Mulakulu/ELE340/Lokalt styresystem/dmk_flytdiagram_lokalt_styrsys.pdf

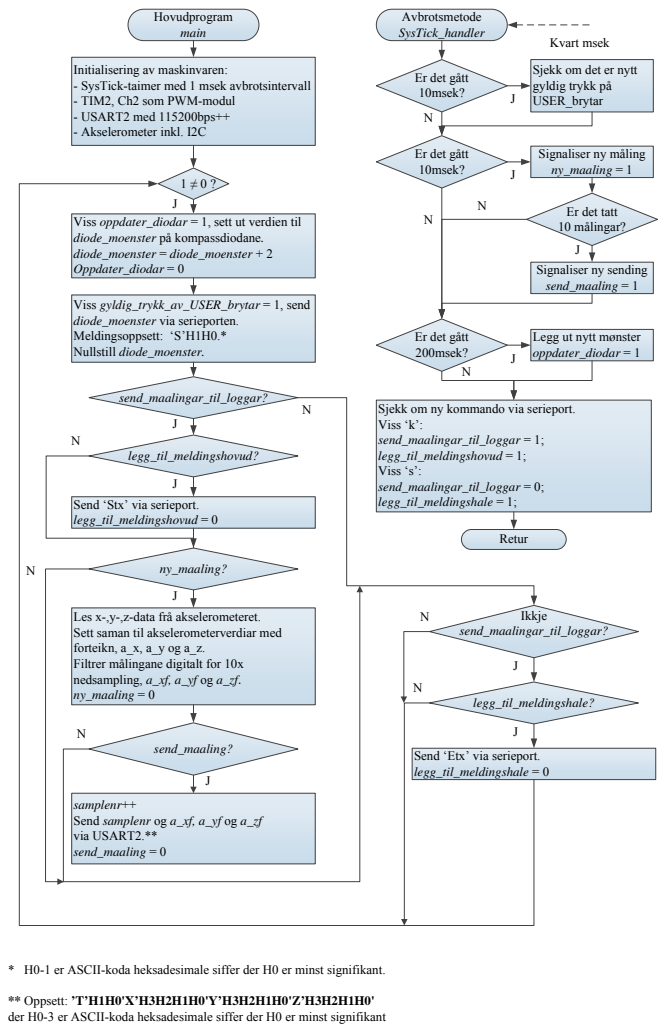
[picture p1: page 1]
Hovudprogram main; Er det gått 10msek?; Legg ut nytt mønster oppdater_diodar = 1; Avbrotsmetode SysTick_handler; Retur; Sjekk om ny kommando via serieport. Viss ‘k’: send_maalingar_til_loggar = 1; legg_til_meldingshovud = 1; Viss ‘s’: send_maalingar_til_loggar = 0; legg_til_meldingshale = 1;; 10msek?; Er det tatt; 10 målingar?; Signaliser ny sending send_maaling = 1; Viss gyldig_trykk_av_USER_brytar = 1, send diode_moenster via serieporten. Meldingsoppsett: ‘S’H1H0.* Nullstill diode_moenster.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

Kvart msek
Sjekk om det er nytt
gyldig trykk på
USER_brytar

Initialisering av maskinvaren:
- SysTick-taimer med 1 msek avbrotsintervall
- TIM2, Ch2 som PWM-modul
- USART2 med 115200bps++
- Akselerometer inkl. I2C

Er det gått

Signaliser ny måling
ny_maaling = 1

Viss oppdater_diodar = 1, sett ut verdien til
diode_moenster på kompassdiodane.
diode_moenster = diode_moenster + 2
Oppdater_diodar = 0

200msek?

Send ‘Stx’ via serieport.
legg_til_meldingshovud = 0

Les x-,y-,z-data frå akselerometeret.
Sett saman til akselerometerverdiar med
forteikn, a_x, a_y og a_z.
Filtrer målingane digitalt for 10x
nedsampling, a_xf, a_yf og a_zf.
ny_maaling = 0

Send ‘Etx’ via serieport.
legg_til_meldingshale = 0

samplenr++
Send samplenr og a_xf, a_yf og a_zf
via USART2.**
send_maaling = 0

* H0-1 er ASCII-koda heksadesimale siffer der H0 er minst signifikant.

** Oppsett: ’T’H1H0'X’H3H2H1H0'Y’H3H2H1H0'Z’H3H2H1H0'
der H0-3 er ASCII-koda heksadesimale siffer der H0 er minst signifikant
