Mulakulu/ELE340/KiCad_files/KiCad_files.kicad_pcb

## KiCad design KiCad_files/KiCad_files.kicad_pcb (2024-11-29)

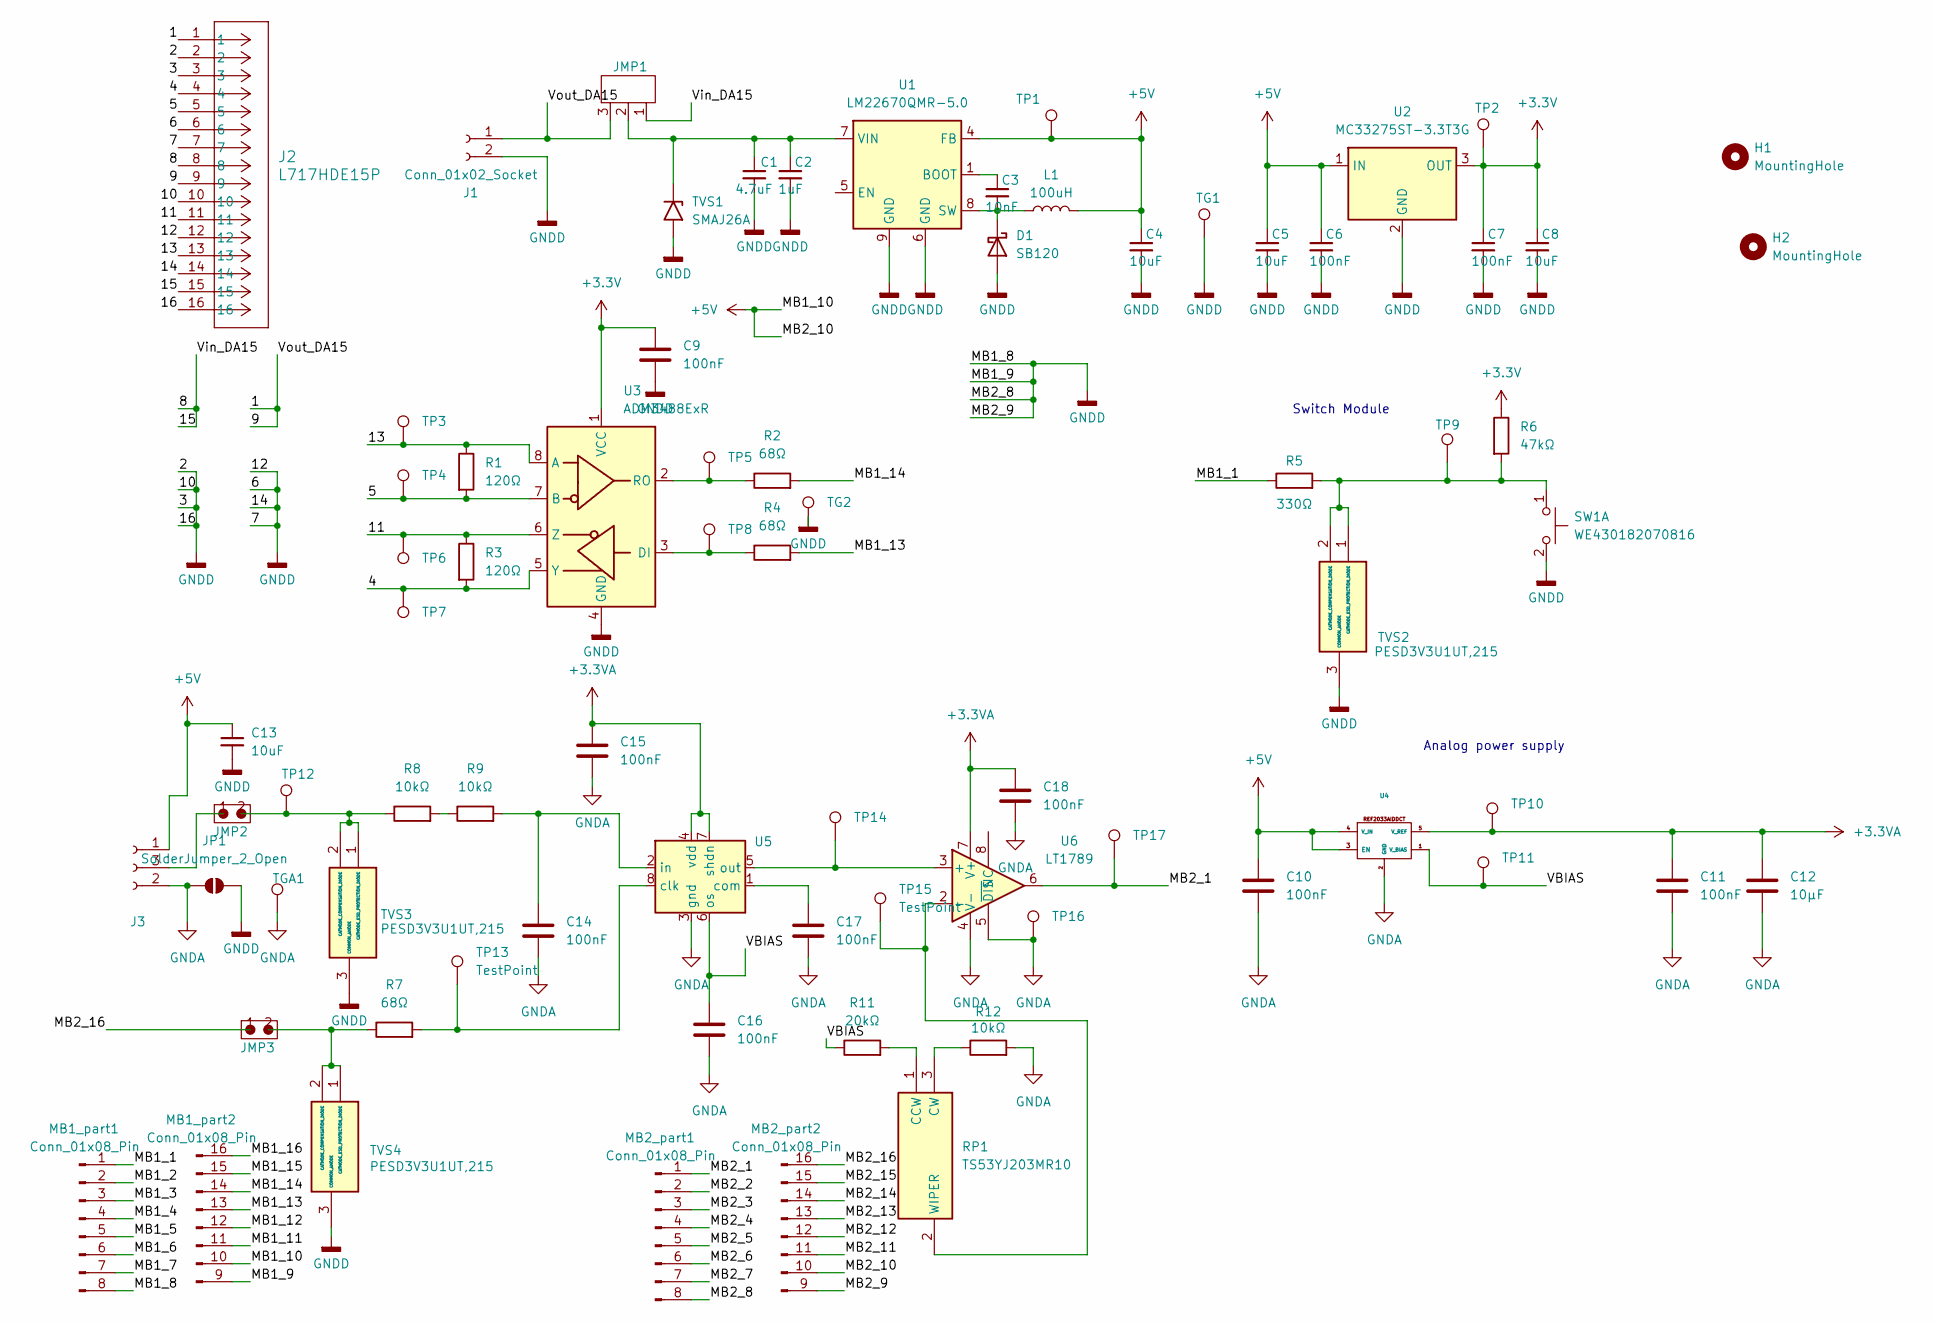
[picture p2: schematic KiCad_files.kicad_sch, Schematic Drawing Proposal]

Parts:
C1: 4.7uF; C_1206_3216Metric_Pad1.33x1.80mm_HandSolder
C2: 1uF; C_1206_3216Metric_Pad1.33x1.80mm_HandSolder
C3: 10nF; C_1206_3216Metric_Pad1.33x1.80mm_HandSolder
C4, C5, C8, C13: 10uF; C_1210_3225Metric_Pad1.33x2.70mm_HandSolder
C6, C7, C9, C10, C11, C14, C15, C16, C17, C18: 100nF; C_1206_3216Metric_Pad1.33x1.80mm_HandSolder
C12: 10μF; C_1210_3225Metric_Pad1.33x2.70mm_HandSolder
D1: SB120; D_MicroSMP_AK
H1, H2: MountingHole; MountingHole_3.2mm_M3
J1: Conn_01x02_Socket; SL35290G
J2: L717HDE15P; 15PinDsub
J3: Conn_01x03_Socket; Pin_Header_1x3_P3.5mm
JMP1: Pin_Header_1x3_P2.54mm
JMP2, JMP3: Pin_Header_2x1_P2.54mm_Vertical
JP1: SolderJumper_2_Open; SolderJumper-2_P1.3mm_Open_RoundedPad1.0x1.5mm
L1: 100uH; SDR2207
MB1_part1, MB2_part1: Conn_01x08_Pin; MB1x8Pins
MB1_part2, MB2_part2: Conn_01x08_Pin; MB1x8Pins_part2
R1, R3: 120Ω; R_1206_3216Metric_Pad1.30x1.75mm_HandSolder
R2, R4, R7: 68Ω; R_1206_3216Metric_Pad1.30x1.75mm_HandSolder
R5: 330Ω; R_1206_3216Metric_Pad1.30x1.75mm_HandSolder
R6: 47kΩ; R_1206_3216Metric_Pad1.30x1.75mm_HandSolder
R8, R9, R12: 10kΩ; R_1206_3216Metric_Pad1.30x1.75mm_HandSolder
R11: 20kΩ; R_1206_3216Metric_Pad1.30x1.75mm_HandSolder
RP1: TS53YJ203MR10; TS53YJ; Manufacturer_Part_Number TS53YJ203MR10
SW1: WE430182070816; Switch WE430182070816
TG1, TG2: TestPoint; testpoint_1.4mm
TGA1: TestPoint; testpoint_1.4mm
TP1, TP2, TP3, TP4, TP5, TP6, TP7, TP8, TP12, TP13, TP14, TP15, TP16, TP17: TestPoint; testpoint_1.4mm
TP9, TP10, TP11: testpoint_1.4mm
TVS1: SMAJ26A; D_SMA
TVS2, TVS3, TVS4: PESD3V3U1UT,215; SOT95P230X110-3N; Manufacturer_Part_Number PESD3V3U1UT,215
U1: LM22670QMR-5.0; SOIC-8-1EP_3.9x4.9mm_P1.27mm_EP2.41x3.81mm
U2: MC33275ST-3.3T3G; SOT-223-3_TabPin2
U3: ADM3488ExR; SOIC-8_3.9x4.9mm_P1.27mm
U4: SOT-23-5
U5: SOIC-8_3.9x4.9mm_P1.27mm
U6: LT1789; SOIC-8_3.9x4.9mm_P1.27mm

Connections:
+3.3V: C7.1, C8.1, C9.1, R6.1, TP2.1, U2.3 (OUT), U3.1 (VCC)
+3.3VA: C11.1, C12.1, C15.1, C18.1, TP10.1, U4.5 (V_REF), U5.4 (vdd), U5.7 (shdn), U6.7 (V+)
+5V: C4.1, C5.1, C6.1, C10.1, C13.1, J3.1, L1.2, MB1_part2.10 (Pin_7), MB2_part2.10 (Pin_7), TP1.1, U1.4 (FB), U2.1 (IN), U4.3 (EN), U4.4 (V_IN)
/1: J1.1, J2.1, J2.9, JMP1.3
/4: J2.4, R3.2, TP7.1, U3.5 (Y)
/5: J2.5, R1.2, TP4.1, U3.7 (B)
/11: J2.11, R3.1, TP6.1, U3.6 (Z)
/13: J2.13, R1.1, TP3.1, U3.8 (A)
/15: J2.8, J2.15, JMP1.1
/MB1_1: MB1_part1.1, R5.1
/MB1_2: MB1_part1.2
/MB1_3: MB1_part1.3
/MB1_4: MB1_part1.4
/MB1_5: MB1_part1.5
/MB1_6: MB1_part1.6
/MB1_7: MB1_part1.7
/MB1_11: MB1_part2.11 (Pin_6)
/MB1_12: MB1_part2.12 (Pin_5)
/MB1_13: MB1_part2.13 (Pin_4), R4.2
/MB1_14: MB1_part2.14 (Pin_3), R2.2
/MB1_15: MB1_part2.15 (Pin_2)
/MB1_16: MB1_part2.16 (Pin_1)
/MB2_1: MB2_part1.1, TP17.1, U6.6
/MB2_2: MB2_part1.2
/MB2_3: MB2_part1.3
/MB2_4: MB2_part1.4
/MB2_5: MB2_part1.5
/MB2_6: MB2_part1.6
/MB2_7: MB2_part1.7
/MB2_11: MB2_part2.11 (Pin_6)
/MB2_12: MB2_part2.12 (Pin_5)
/MB2_13: MB2_part2.13 (Pin_4)
/MB2_14: MB2_part2.14 (Pin_3)
/MB2_15: MB2_part2.15 (Pin_2)
/MB2_16: JMP3.1, MB2_part2.16 (Pin_1)
/VBIAS: C16.1, R11.1, TP11.1, U4.1 (V_BIAS), U5.6 (os)
GNDA: C10.2, C11.2, C12.2, C14.2, C15.2, C16.2, C17.2, C18.2, J3.2 (Pin_3), JP1.1 (A), R12.2, TGA1.1, TP16.1, U4.2 (GND), U5.3 (gnd), U6.4 (V-), U6.5 (~DIS)
GNDD: C1.2, C2.2, C4.2, C5.2, C6.2, C7.2, C8.2, C9.2, C13.2, D1.2 (A), J1.2, J2.2, J2.3, J2.6, J2.7, J2.10, J2.12, J2.14, J2.16, JP1.2 (B), MB1_part1.8, MB1_part2.9 (Pin_8), MB2_part1.8, MB2_part2.9 (Pin_8), SW1.2 (D), TG1.1, TG2.1, TVS1.2 (A2), TVS2.3 (COMMON_ANODE), TVS3.3 (COMMON_ANODE), TVS4.3 (COMMON_ANODE), U1.6 (GND), U1.9 (GND), U2.2 (GND), U3.4 (GND)
unnamed: C3.2, D1.1 (K), L1.1, U1.8 (SW)
unnamed: J3.3 (Pin_2), JMP2.1
unnamed: R8.2, R9.1
unnamed: R11.2, RP1.1 (CCW)
unnamed: R12.1, RP1.3 (CW)
unnamed: RP1.2 (WIPER), TP15.1, U6.2 (-)
unnamed: R5.2, R6.2, SW1.1 (C), TP9.1, TVS2.1 (CATHODE_ESD_PROTECTION_DIODE), TVS2.2 (CATHODE_COMPENSATION_DIODE)
unnamed: C1.1, C2.1, JMP1.2, TVS1.1 (A1), U1.7 (VIN)
unnamed: JMP2.2, R8.1, TP12.1, TVS3.1 (CATHODE_ESD_PROTECTION_DIODE), TVS3.2 (CATHODE_COMPENSATION_DIODE)
unnamed: JMP3.2, R7.1, TVS4.1 (CATHODE_ESD_PROTECTION_DIODE), TVS4.2 (CATHODE_COMPENSATION_DIODE)
unnamed: C3.1, U1.1 (BOOT)
unnamed: R4.1, TP8.1, U3.3 (DI)
unnamed: R2.1, TP5.1, U3.2 (RO)
unnamed: R7.2, TP13.1, U5.8 (clk)
unnamed: C17.1, U5.1 (com)
unnamed: C14.1, R9.2, U5.2 (in)
unnamed: TP14.1, U5.5 (out), U6.3 (+)

Notes on the sheet:
Switch Module
Analog power supply

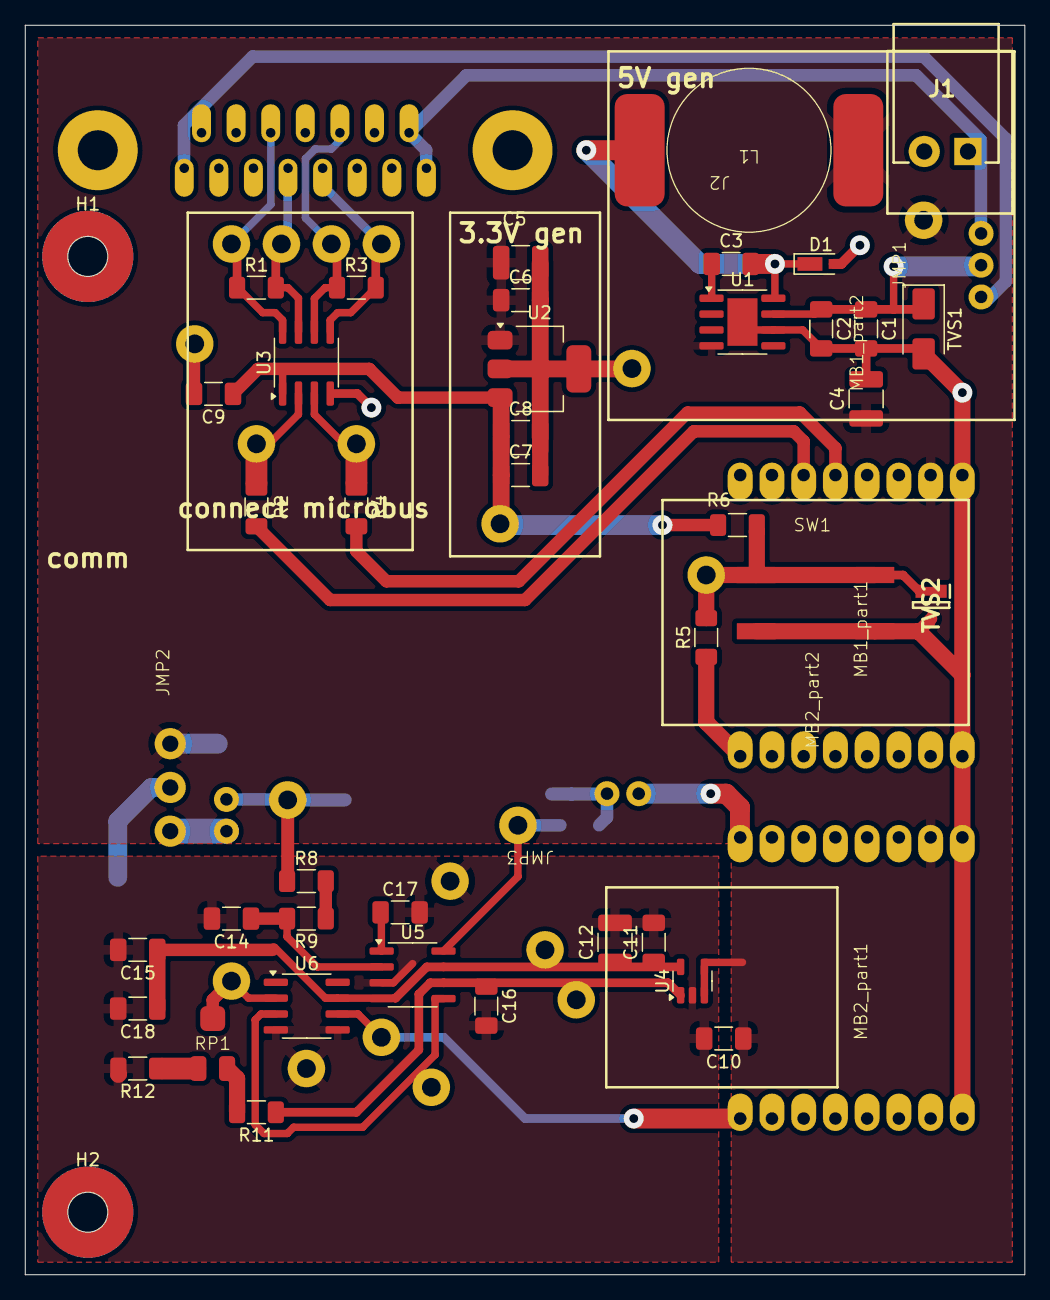
[picture p3: board KiCad_files.kicad_pcb from above]

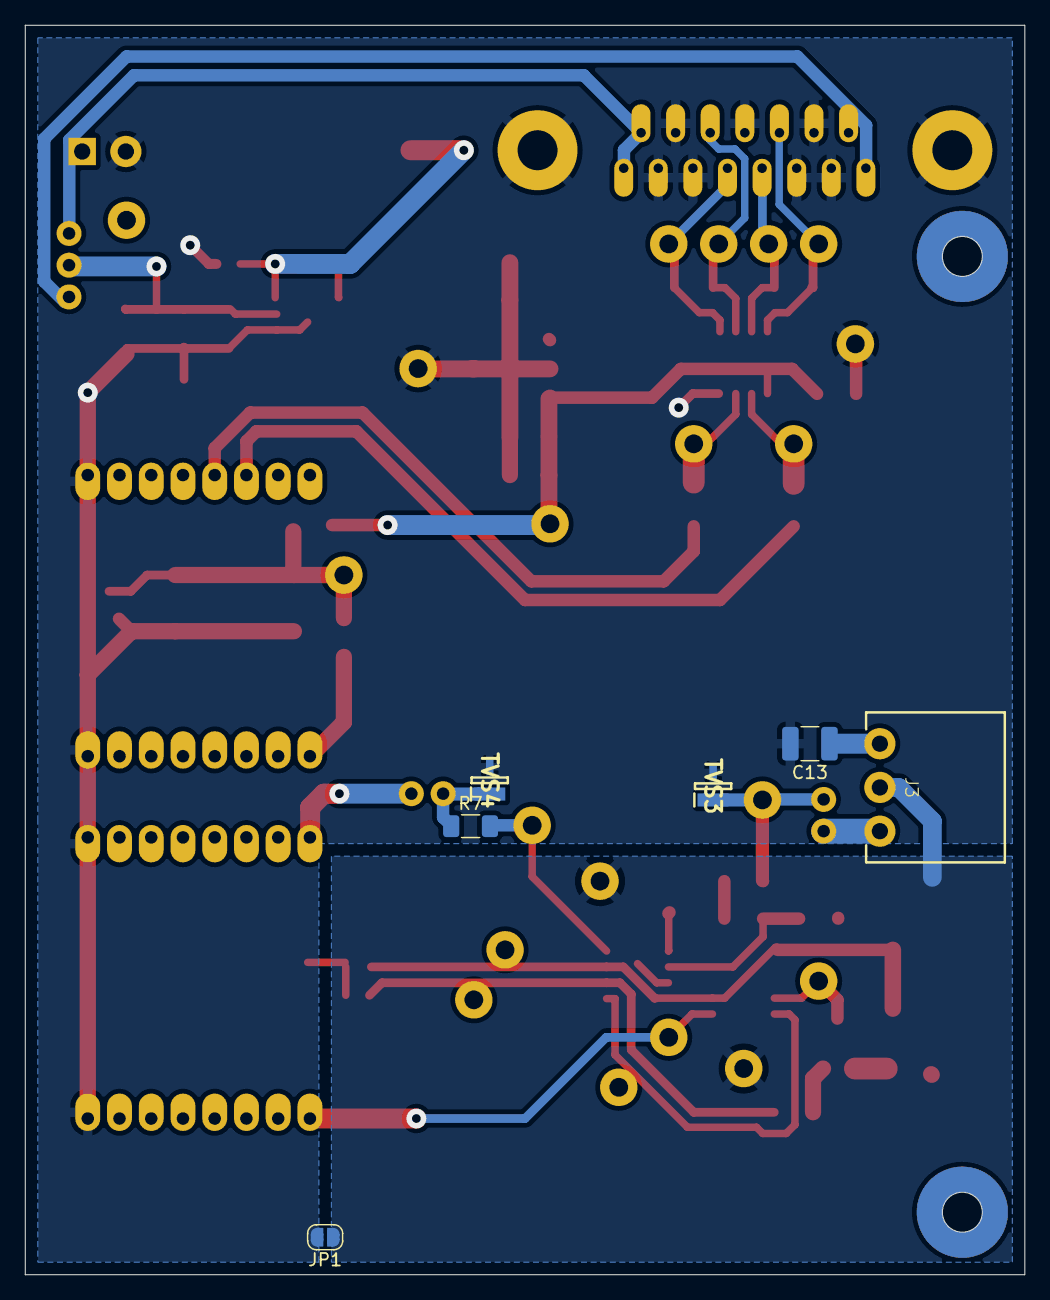
[picture p4: board KiCad_files.kicad_pcb from below]

Board: 2 copper layers, 80.0 x 100.0 mm, 76 parts (6 on the bottom side), 34 nets.
