Mulakulu/ELE340/(commit log)

2024-09-24 Added kicad folder and files
    [KiCad files.kicad_pcb, KiCad files.kicad_sch]
2024-09-24 Re-added kicad files
2024-09-24 removed trash copy
    [KiCad files.kicad_pcb, KiCad files.kicad_sch]
2024-09-24 added schematic file
    [KiCad_files.kicad_sch]
2024-09-24 added the analog power supply to the main scheme
    [KiCad_files.kicad_sch]
2024-09-24 Added digital power supply to schematic
    [KiCad_files.kicad_sch]
2024-09-24 minimal changes
    [KiCad_files.kicad_sch]
2024-09-24 i changed the ground to gnda on the analog power supply
    [KiCad_files.kicad_sch]
2024-09-24 i inserted the RS422 communication circuit to the mains scheme
    [KiCad_files.kicad_sch]
2024-09-25 The switch Module done!
    [KiCad_files.kicad_sch]
2024-09-26 Made the schematic somewhat presentable and filled out the last bit of the circuit
    [KiCad_files.kicad_sch]
2024-09-27 Added stm32 project back in
2024-10-01 Not sure how much I've done in the STM32
2024-10-08 added a pcb design file
2024-10-08 i inserted some footprints
    [KiCad_files.kicad_sch]
2024-10-08 added L footprint
    [KiCad_files.kicad_sch]
2024-10-08 added pcb file
    [KiCad_files.kicad_pcb]
2024-10-08 changed the switch and what's under it
    [KiCad_files.kicad_sch]
2024-10-08 Added project library
    [KiCad_files.kicad_pcb, KiCad_files.kicad_sch]
2024-10-08 Actually added the footprint tables for sharing
2024-10-08 added footprint for pin headers and updated footprints
    [KiCad_files.kicad_sch]
2024-10-08 fixed all resistor footprints
    [KiCad_files.kicad_sch]
2024-10-08 added testpoint footprint
2024-10-08 i made a footprint for jmp1
2024-10-08 Added footprints to testpoints
    [KiCad_files.kicad_sch]
2024-10-08 updated library
    [KiCad_files.kicad_sch]
2024-10-15 i fixed all of the errors from the schematic design
    [KiCad_files.kicad_sch]
2024-10-15 fixed references and labels
    [KiCad_files.kicad_sch]
2024-10-17 worked on the pcb design details
2024-10-17 fixed pcb design details
    [KiCad_files.kicad_sch]
2024-10-17 added pcb design file
    [KiCad_files.kicad_pcb]
2024-10-17 Alligned microbus on PCB
    [KiCad_files.kicad_pcb]
2024-10-17 Added schematic model to 15pindsub
    [KiCad_files.kicad_pcb, KiCad_files.kicad_sch]
2024-10-17 added footprints
2024-10-17 Minor work on the PCB
    [KiCad_files.kicad_pcb, KiCad_files.kicad_sch]
2024-10-21 fixed J3
    [KiCad_files.kicad_pcb]
2024-10-21 Updated some of the PCB
    [KiCad_files.kicad_pcb, KiCad_files.kicad_sch]
2024-10-21 Significant progress on the PCB
    [KiCad_files.kicad_pcb, KiCad_files.kicad_sch]
2024-10-21 some footprints(maybe)
2024-10-22 placed some testpoints and shortened nets
    [KiCad_files.kicad_pcb]
2024-10-22 Some more progress on the PCB
    [KiCad_files.kicad_pcb, KiCad_files.kicad_sch]
2024-10-22 placed components and drew lines
    [KiCad_files.kicad_pcb]
2024-10-22 Completed first version of the PCB
    [KiCad_files.kicad_pcb, KiCad_files.kicad_sch]
2024-10-23 Minor changes to the PCB and added a problems list
    [KiCad_files.kicad_pcb, KiCad_files.kicad_sch]
2024-10-23 Forgot to save. Lol
    [KiCad_files.kicad_pcb]
2024-10-23 Unremarkable changes
    [KiCad_files.kicad_pcb]
2024-10-24 Minor changes to problems with the PCB
2024-10-29 fixed one footprint
    [KiCad_files.kicad_sch]
2024-10-31 checked for errors in the analog circuit
2024-11-05 Fixed all 'problems'
    [KiCad_files.kicad_pcb, KiCad_files.kicad_sch]
2024-11-06 Finalizing the PCB. Fixed mounting holes and flipped some components to the other side so jumpers can be soldered easily
    [KiCad_files.kicad_pcb]
2024-11-29 Added a stm32 project with a working ADC
    [KiCad_files.kicad_pcb]
2024-12-01 Added clock signal and smoothing function for the ADC in the sensor node
